HexabitzPlatform/H3BR6x-Hardware/README.md

# H3BR6x-Hardware
Hexabitz 6-Digit 7-Segment Display Module Hardware Design
