HexabitzPlatform/H3BR6x-Hardware/Rleased/BOM/H3BR61 BOM.xlsx

Qty | Value | Designator | Description | MFN | MPN | OCTOPART_URL
4 | LED3mm RED | LED1, LED2, LED3, LED4 | LED 3mm RED Collor | Vishay | TLHK4600 | https://octopart.com/tlhk4600-vishay-39410044?r=sp
1 | PINHD-1X1 | JP1 | PCB Header, Unshrouded, Thru 02 Straight Header, .101, AMPMODU Mod II Series | TE Connectivity | 87227-1 | https://octopart.com/87227-1-te+connectivity-39512052?r=sp
1 | PINHD-1X3 | JP2 | Conn Unshrouded Header HDR 3 POS 2.54mm Solder ST Top Entry Thru-Hole Carton | TE Connectivity | 5-146281-3 | https://octopart.com/5-146281-3-te+connectivity+%2F+amp-39745942?r=sp
4 | 100nF | C1, C3, C5, C6 | CAP CER 10% X7R 0603 | KEMET | C0603C104K8RACTU | https://octopart.com/c0603c104k8ractu-kemet-145075?r=sp&s=9bS9ASSwSEqMCE9KBEQZ0g
1 | 1.00uF | C4 | CAP CER 1UF 16V X7R 0805 | YAGEO [VA] | CC0805KKX7R7BB105 | https://octopart.com/cc0805kkx7r7bb105-yageo-8376555?r=sp
2 | 4.7uF | C2, C7 | CAP TANT 4.7UF 10V 20% 0805 | Panasonic | 10TPU4R7MSI | https://octopart.com/10tpu4r7msi-panasonic-29487748?r=sp (https://octopart.com/grm21bc81e475ka12l-murata-10331911?r=sp&s=RY3qZSD8T6mG6TC9CHI5qQ)
1 | 0.0R | R2 | RES SMD 0.0OHM JUMPER 1/10W 0603 | YAGEO [VR] | RC0603JR-070RL | https://octopart.com/rc0603jr-070rl-yageo-1241539?r=sp
8 | 100R | R12, R13, R14, R15, R16, R17, R18, R19 | Thick Film Resistors - SMD 0603 | Yageo | RC0603FR-07100RL | https://octopart.com/rc0603fr-07100rl-yageo-55402879?r=sp
1 | 270.0R | R3 | Thick Film Resistors - SMD 0603 270ohms 5% Tol | Panasonic | ERJ-3GEYJ271V | https://octopart.com/erj-3geyj271v-panasonic-55560546?r=sp
16 | 10K | R1 ,R4, R5, R6, R7, R8, R9, R10, R11, R20, R21, R22, R23, R24, R25, R26 | RES 10 K OHM 5% 0603 | Vishay | CRCW060310K0JNEB | https://octopart.com/crcw060310k0jneb-vishay-46603269
1 | Display 6 DIG | 3661BS | 0.36 inch 6digits RED 8 segment led display Common Anode |  | 3661BS | https://www.aliexpress.com/item/1326420858.html
1 | FB-TDK_MMZ1608Y300B | FB1 | Ind chip Bead Multi-Layer 30 ohms 25% 100MHZ Ferrite 1,5A 0603Punched paper T/R | TDK | MMZ1608Y300BTA00 | https://octopart.com/mmz1608y300bta00-tdk-7906990?r=sp
7 | MMBT3906LT1 | Q1, Q2, Q3, Q4, Q5, Q6, Q15 | Trans GP BJT PNP 40V 0.2A 330mW Automotive 3-Pin SOT-23 T/R | Infineon | MMBT3906LT1HTSA1 | https://octopart.com/mmbt3906lt1htsa1-infineon-21387160?r=sp
8 | MMBT3904LT1 | Q7, Q8, Q9, Q10, Q11, Q12, Q13, Q14 | Transistor, Bipolar, Si, NPN, General Purpose, VCEO 40VDC, IC 200mA, PD 225mW, SOT-23 | ON Semiconductor | MMBT3904LT1G | https://octopart.com/mmbt3904lt1g-on+semiconductor-3280?r=sp
1 | STM32G0B1CEU6N | U1 | MCU 32-Bit ARM Cortex-M0+ RISC 512kByte Flash 1.7V to 3.6V 48-Pin UFQFPN Tray | STMicroelectronics | STM32G0B1CEU6N | https://octopart.com/stm32g0b1ceu6n-stmicroelectronics-116364672?r=sp
1 | RED | D1 | Red 0603 130آ° Clear 54 mcd 2 V Surface Mount ChipLED ; | Vishay | VLMS1300-GS08 | https://octopart.com/vlms1300-gs08-vishay-21709201?r=sp&s=0nXJNjGsSbWwqfqWlZv0EA
1 | XTALL_CSTCE8M00G52 | X1 | 8,0000MHZ 33pF SMD MURATA Resonators | Murata | CSTNE8M00G550000R0 | https://octopart.com/cstne8m00g550000r0-murata-91406934?r=sp
