HexabitzPlatform/H3BR6x-Hardware/Documentation/H3BR61_Hardware SCH.pdf

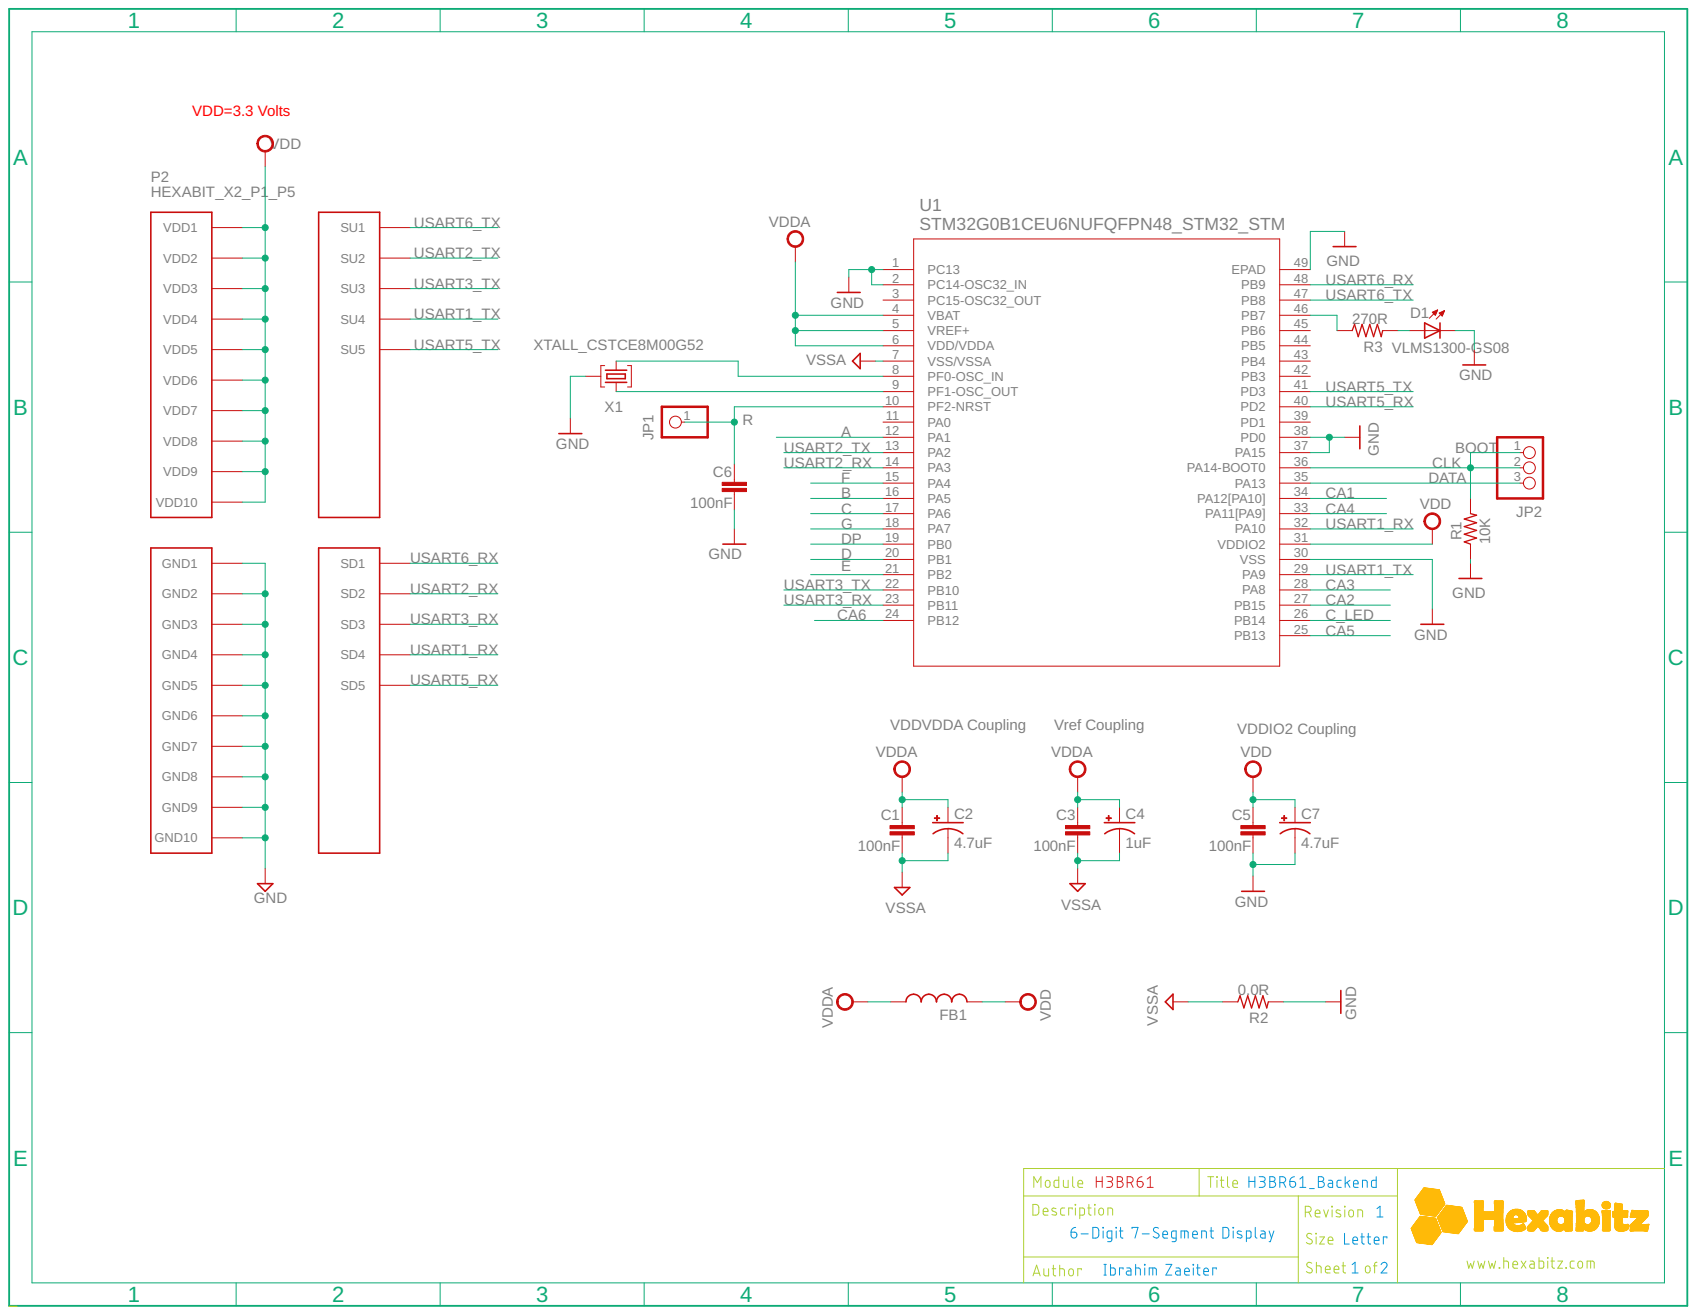
[picture p1: page 1]

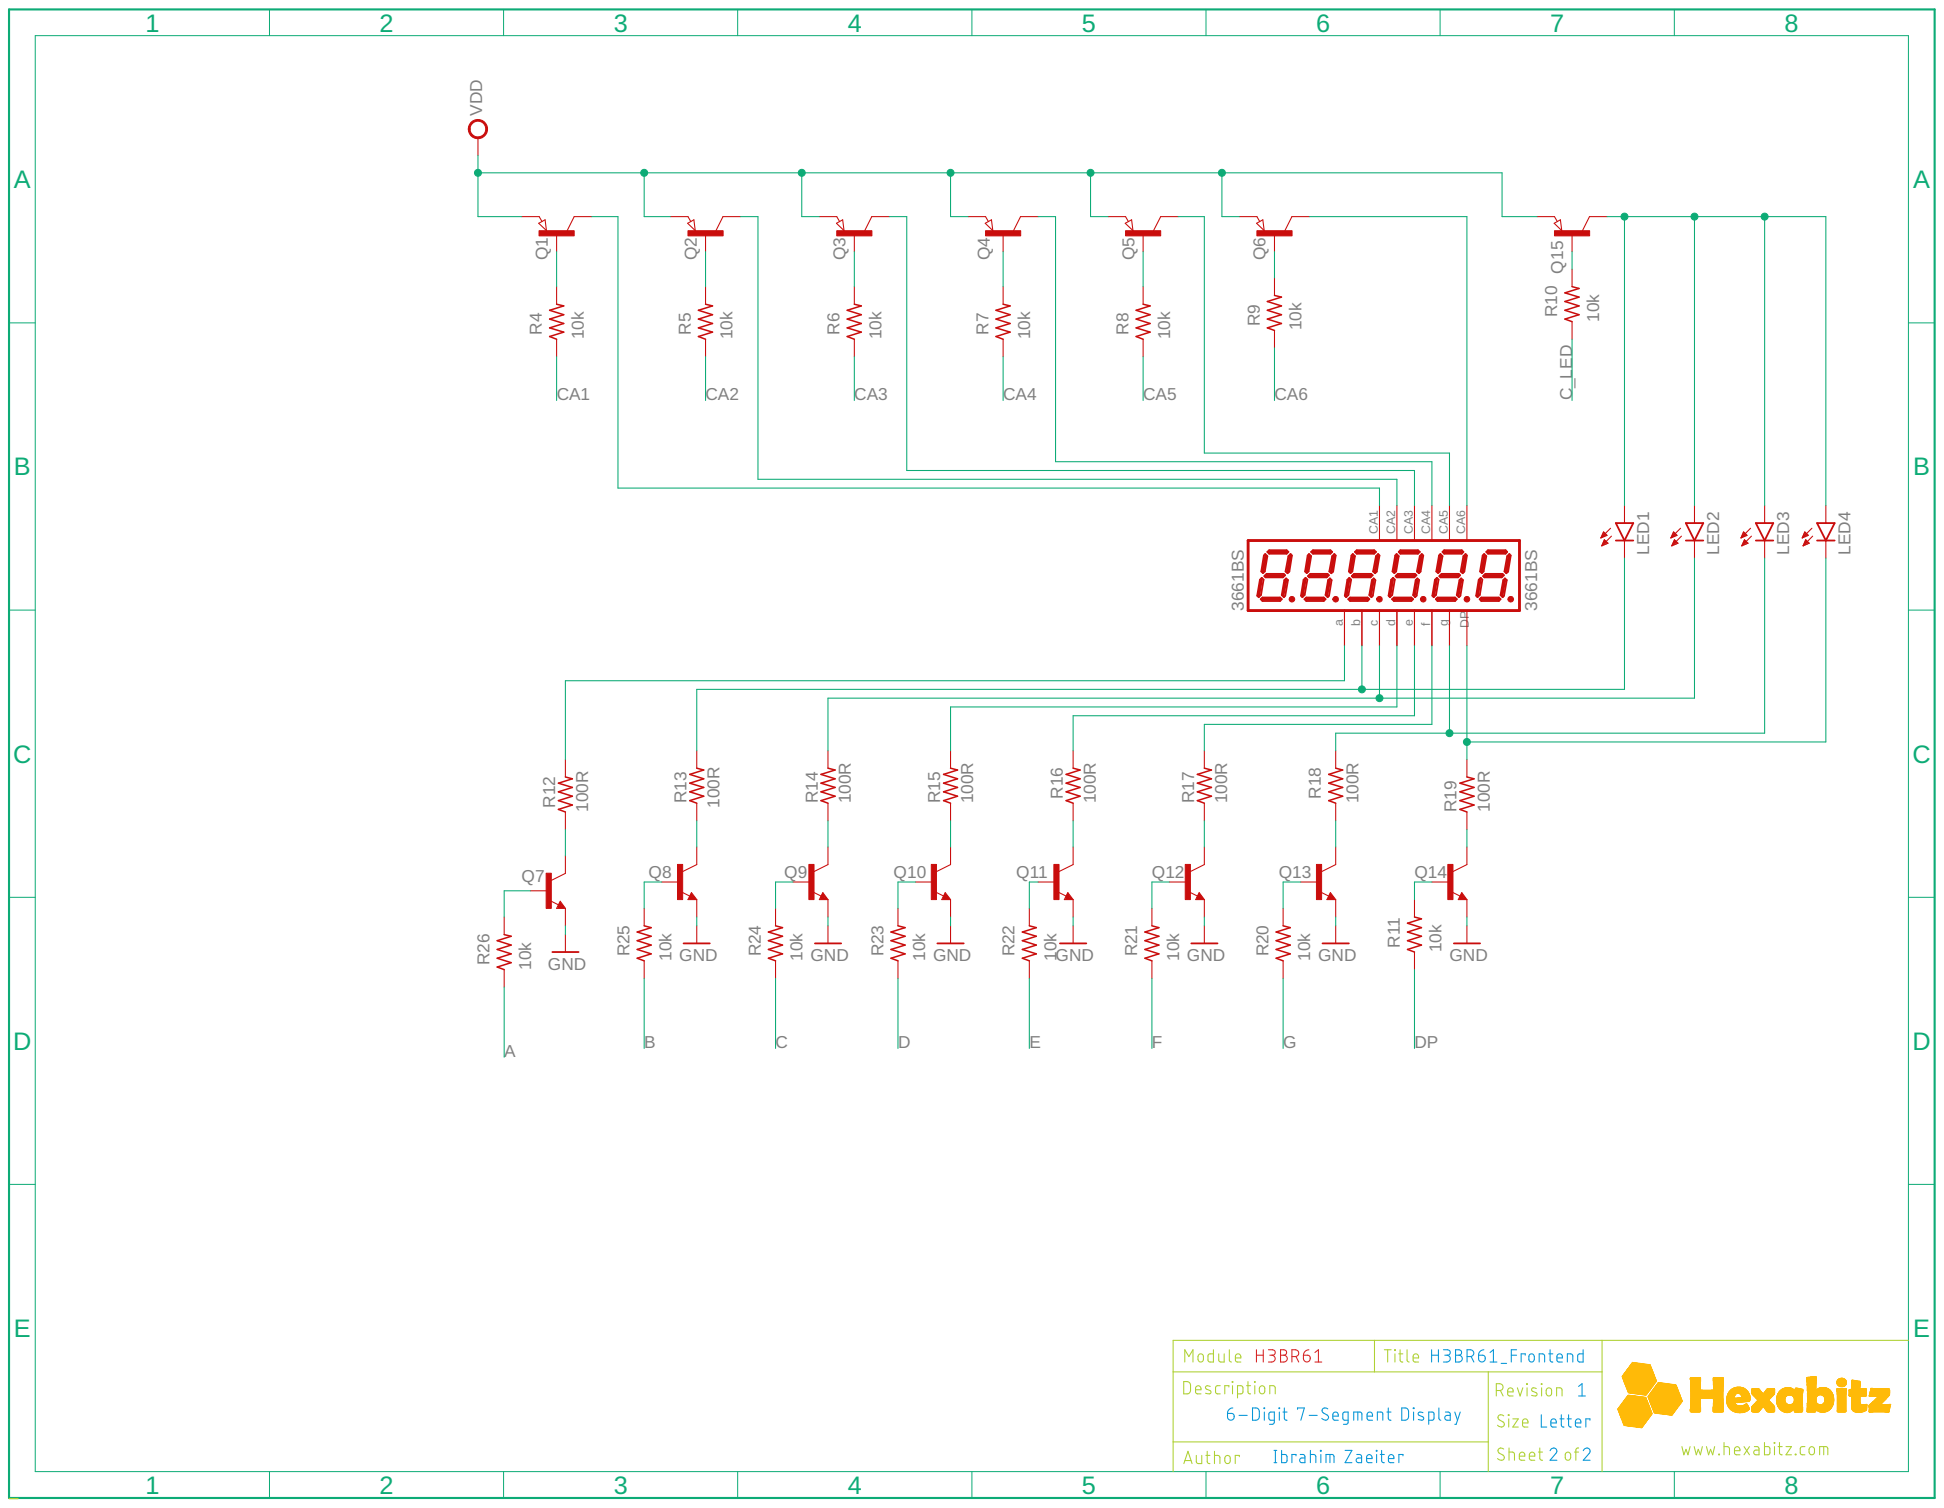
[picture p2: page 2]
