HexabitzPlatform/H3BR6x-Hardware/(commit log)

2020-11-28 Finishing PCB
    [H3BR6_Hardware.brd]
2020-11-28 Fix Wire Width
    [H3BR6_Hardware.brd]
2020-11-29 Final Design REV 1
    [H3BR6_Hardware.brd]
2020-12-02 Relase REV 1
    [H3BR6_Hardware.brd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]
2021-04-20 Release REV0
    [H3BR6 BOM.xlsx, H3BR6_Hardware.brd, H3BR6_Hardware.sch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]
2021-04-21 FIX Rev0
    [H3BR6_Hardware.brd, H3BR6_Hardware.sch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]
2021-04-22 - Updated BOM..
    [H3BR6 BOM.xlsx]
2022-04-30 -Changing the MC with STM32G0
    [H3BR6 BOM.xlsx, H3BR6_Hardware.brd, H3BR6_Hardware.sch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]
2022-08-23 Correcting the Revision number
    [H3BR61 BOM.xlsx, H3BR61_Hardware.brd, H3BR61_Hardware.sch]
2023-02-15 -Correcting some documentaion issues
    [H3BR61 BOM.xlsx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]
